hzeller/microorb/README.md

Microorb
========

A USB connected high-power RGB LED. Before there were cheap RGB devices for
USB, this is what we used to show continuous build status on the developers'
workstations.
