hzeller/microorb/hardware/orb-4.brd

## EAGLE design hardware/orb-4.brd (2016-12-11)

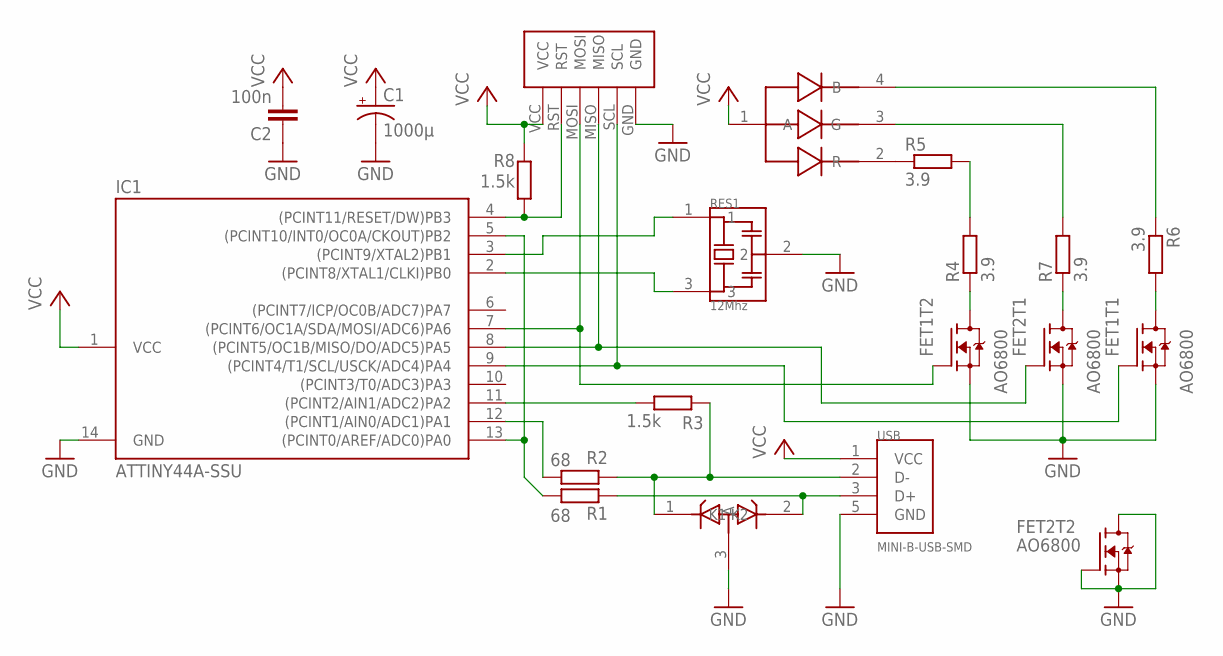
[picture p1: schematic orb-4.sch]

Parts:
C1: 1000µ; PANASONIC_F
C2: 100n; C0805K
D1: 3.6V; SOT23
FET1, FET2: AO6800; TSOP6
IC1: ATTINY44A-SSU; SOIC14
R1, R2: 68; M0805
R3, R8: 1.5k; M0805
R4, R5, R6, R7: 3.9; R2512
RES1: 12Mhz; AWSCR-CV
U$1: 5W-RGB; 5W-POWER-LED
U$2: PROG-HEADER; SMALL-PROG-HEADER
USB: MINI-B-USB-SMD; USB-UX60SC-SMD

Connections:
D+: D1.2 (K2), R1.1, USB.3 (D+)
D-: D1.1 (K1), R2.1, R3.2, USB.2 (D-)
GND: C1.-, C2.1, D1.3 (A), FET1.2 (S), FET1.5 (S), FET2.2 (S), FET2.3 (G), FET2.4 (D), FET2.5 (S), IC1.14 (GND), RES1.2, U$2.GND, USB.5 (GND)
unnamed: IC1.2 ((PCINT8/XTAL1/CLKI)PB0), RES1.3
unnamed: IC1.3 ((PCINT9/XTAL2)PB1), RES1.1
unnamed: FET1.3 (G), IC1.7 ((PCINT6/OC1A/SDA/MOSI/ADC6)PA6), U$2.MOSI
unnamed: IC1.11 ((PCINT2/AIN1/ADC2)PA2), R3.1
unnamed: IC1.5 ((PCINT10/INT0/OC0A/CKOUT)PB2), IC1.13 ((PCINT0/AREF/ADC0)PA0), R1.2
unnamed: IC1.12 ((PCINT1/AIN0/ADC1)PA1), R2.2
unnamed: FET1.4 (D), R4.1
unnamed: FET2.6 (D), R7.1
unnamed: FET1.6 (D), R6.2
unnamed: R5.1, U$1.2 (R)
unnamed: R7.2, U$1.3 (G)
unnamed: R6.1, U$1.4 (B)
unnamed: FET2.1 (G), IC1.8 ((PCINT5/OC1B/MISO/DO/ADC5)PA5), U$2.MISO
unnamed: FET1.1 (G), IC1.9 ((PCINT4/T1/SCL/USCK/ADC4)PA4), U$2.SCL
unnamed: R4.2, R5.2
RESET: IC1.4 ((PCINT11/RESET/DW)PB3), R8.1, U$2.RST
VCC: C1.+, C2.2, IC1.1 (VCC), R8.2, U$1.1 (A), U$2.VCC, USB.1 (VCC)

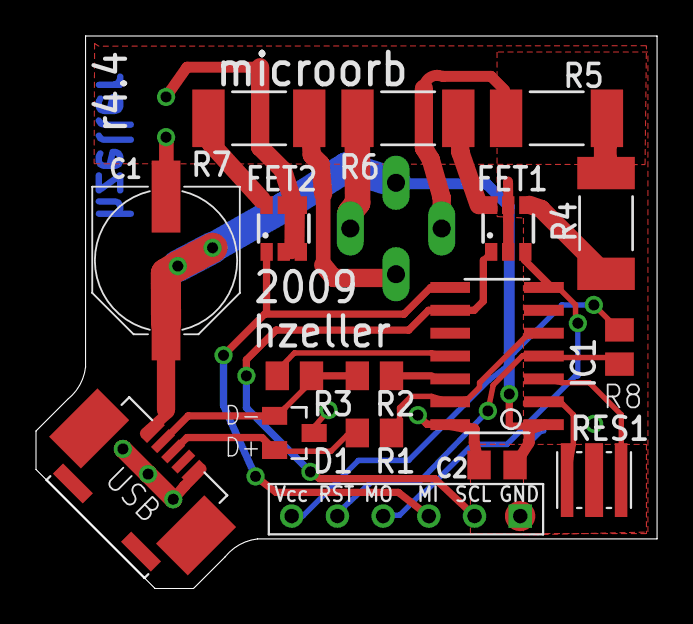
[picture p2: board orb-4.brd from above]

Board: 2 copper layers, 34.5 x 30.7 mm, 18 parts (1 on the bottom side), 20 nets.
