hzeller/microorb/(commit log)

2009-08-14 o Unsuccessful attempt to do two-segment two OCA/OCB timer thing. Too much problems with timing of close events.
    [orb.c]
2009-09-04 o Switch to new 'final' hardware layout (some bits shifted) o start moving PWM back in the main loop. The timing won't work.
    [orb.c]
2009-09-21 o Add simplified gamma correction.
    [orb.c]
2009-09-26 o increase device version to 1.04 so that hostprogram can detect that no current limiting is necessary. o Increase sequence len to 8 o Init google startup sequence.
2009-09-28 o make #defines for ports enums. o current limiting to 500mA o 'white' balance: limit current of blue.
2009-09-30 o store in eeprom - serial number - flag if we should do current limiting - initial sequence o implement 'get_color()'
    [ir.sch, spi.sch]
2009-09-30 o remove irrelevant part of usbtiny-1.4 o add README.orb o add more elements to the black-phase.
    [ir.sch, spi.sch]
2009-09-30 o add current_limit capability flag.
2009-09-30 o add prototypes to functions. o Name functions consistently so that it is clear what datatype they manipulate ('object oriented in C') o Do fixedpoint arithmetic with a shift of 24 so that a simple 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
    [orb.c]
2009-10-01 o experimental timer testing.
2009-10-01 o provide proper padding for fixvalue register.
    [orb.c]
2009-10-01 o only set pwm_segments[3] once.
2009-10-01 o temporary state: debugging why usb protocol errors occur sometime.
    [orb.c]
2009-10-01 o use less memory. Looks like we were using too much (usb stopped working) o stray in some usb_poll()'s
    [orb.c]
2009-10-12 o check the current limit bit after setting eeprom. That way we don't have to reset the orb for the limit to become active. o initial sequence a bit more often. o use timer by default.
    [orb.c]
2009-10-12 o start from current color for sequence.
2009-10-12 o update fuses in Makefile.
2010-02-22 o Add current limiting for older orbs.
2010-02-22 o more documentation for the current limiting.
2011-09-24 Add hardware
    [orb-4.brd, orb-4.sch]
2011-10-05 o Re-add reset pull-up. o add revision text (r4.1)
    [orb-4.brd, orb-4.sch]
2011-10-11 o revision 4.4
    [orb-4.brd]
2011-10-11 o add measurements and documentation 'layer' o output gerber for it and documentation.
    [orb-4.brd]
2011-10-13 o add usbtiny 1.6 upstream
    [ir.sch, spi.sch]
2011-10-13 o remove uneccessary stuff from usbtiny distribution.
    [ir.sch, spi.sch]
2011-10-13 o really clean fab and print dir.
2011-10-13 o make dir clean work in case there are no dirs :)
2011-10-25 o add assembly documentation.
2012-01-22 o Externalize light sensor for better implementation.
2012-01-26 o Print fuse.
2012-01-26 o update README
    [orb-4.brd]
2016-12-11 o make usb tiny compile with current compilers.
2016-12-11 o Load and save eagle files to convert from 5.x version to 7.x version that is XML
    [orb-4.brd, orb-4.sch]
2016-12-11 o update text.
    [orb-4.brd]
