hzeller/microorb/(notices)

Notices in the files:
software/usb-host/main.cc:
Copyright (c) 2008 Henner Zeller <h.zeller@acm.org>
under the terms of the GNU General Public License version 2, as published
by the Free Software Foundation <http://www.gnu.org/copyleft/>.
software/firmware/usbtiny.h:
This is free software, licensed under the terms of the GNU General
Public License as published by the Free Software Foundation.
